siliconvalley4066/STM32F103C8T6TFTOscilloscope/(threads)

Thread 1 (2025-05-12):

No space enough with STM32F103C8T6 (BluePill)

carlonb, 2025-05-12:
I selected STM32F103C8T6 as board but the compiler says  "Sketch too big"
Can I remove some feature?
Thanks
carlo

Closed 2025-05-26.
