siliconvalley4066/STM32F103C8T6TFTOscilloscope/(commit log)

2023-11-29 implement DMA
2024-01-04 fix ADC2 setting
    fix ADC2 setting
    change library from Adafruit_ILI9341 to Adafruit_ILI9341_STM
    [GOscillo.ino, adc_dma.ino, gui.ino]
2024-03-08 arduinoFFT 2.0.0
    arduinoFFT was updated to 2.0.0 and the API was changed.
2024-03-08 arduinoFFT 2.0.0
    Adapt for update of arduinoFFT 2.0.0
2024-03-19 fix regular simultaneous mode and fast interleaved mode.
    [GOscillo.ino, adc_dma.ino]
2024-04-16 PWM lower frequency
    Extend PWM lower frequency to 0.01676Hz
2024-07-03 fix PWM max frequency to 50%
    [GOscillo.ino, gui.ino]
2025-05-03 add calibration to the frequency counte
